Mbutton-umich/Muscle_Shirt/filterI.png

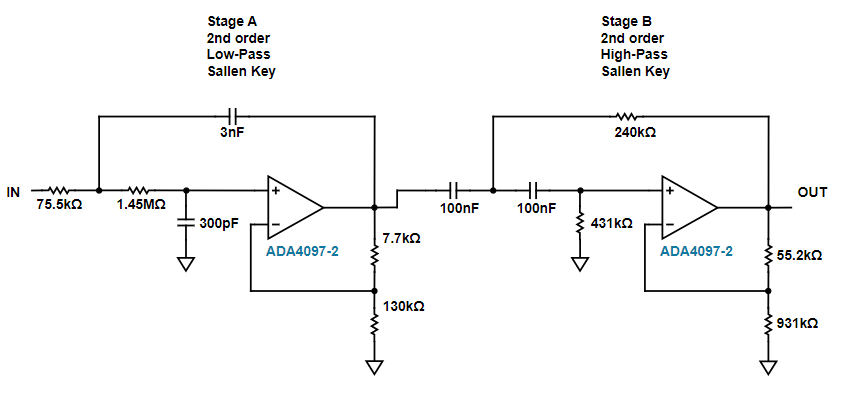
filterI.png
