Mbutton-umich/Muscle_Shirt/filterII.png

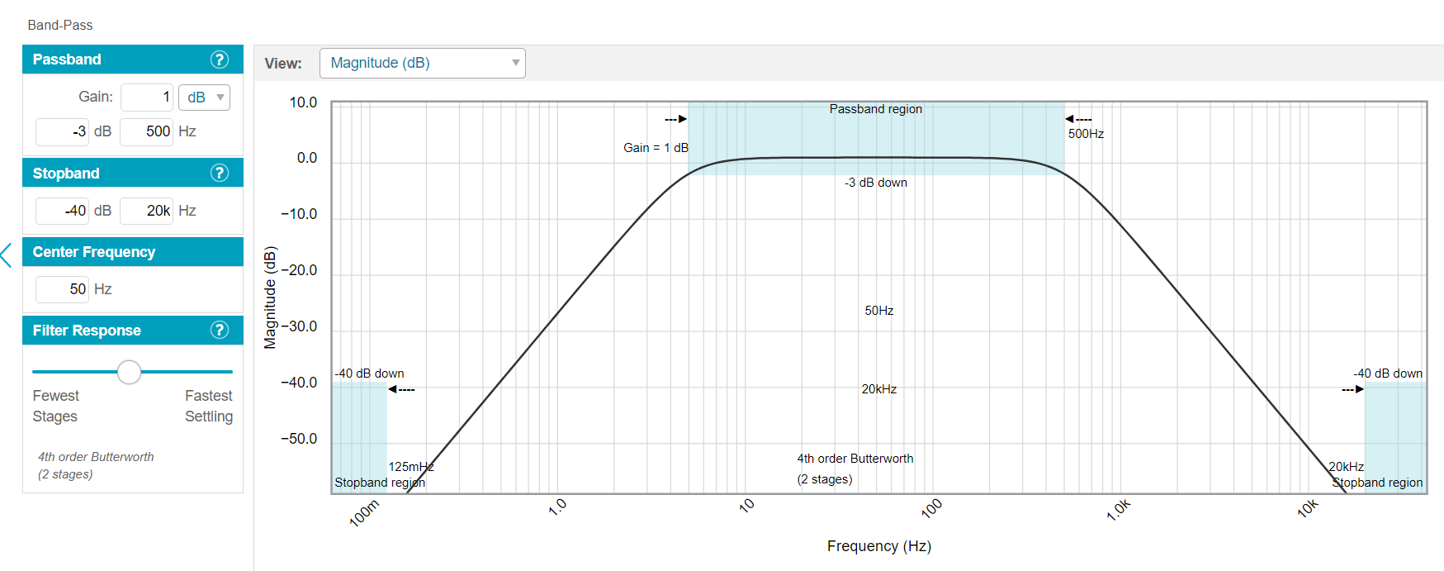
filterII.png
