Mbutton-umich/Muscle_Shirt/headers.png

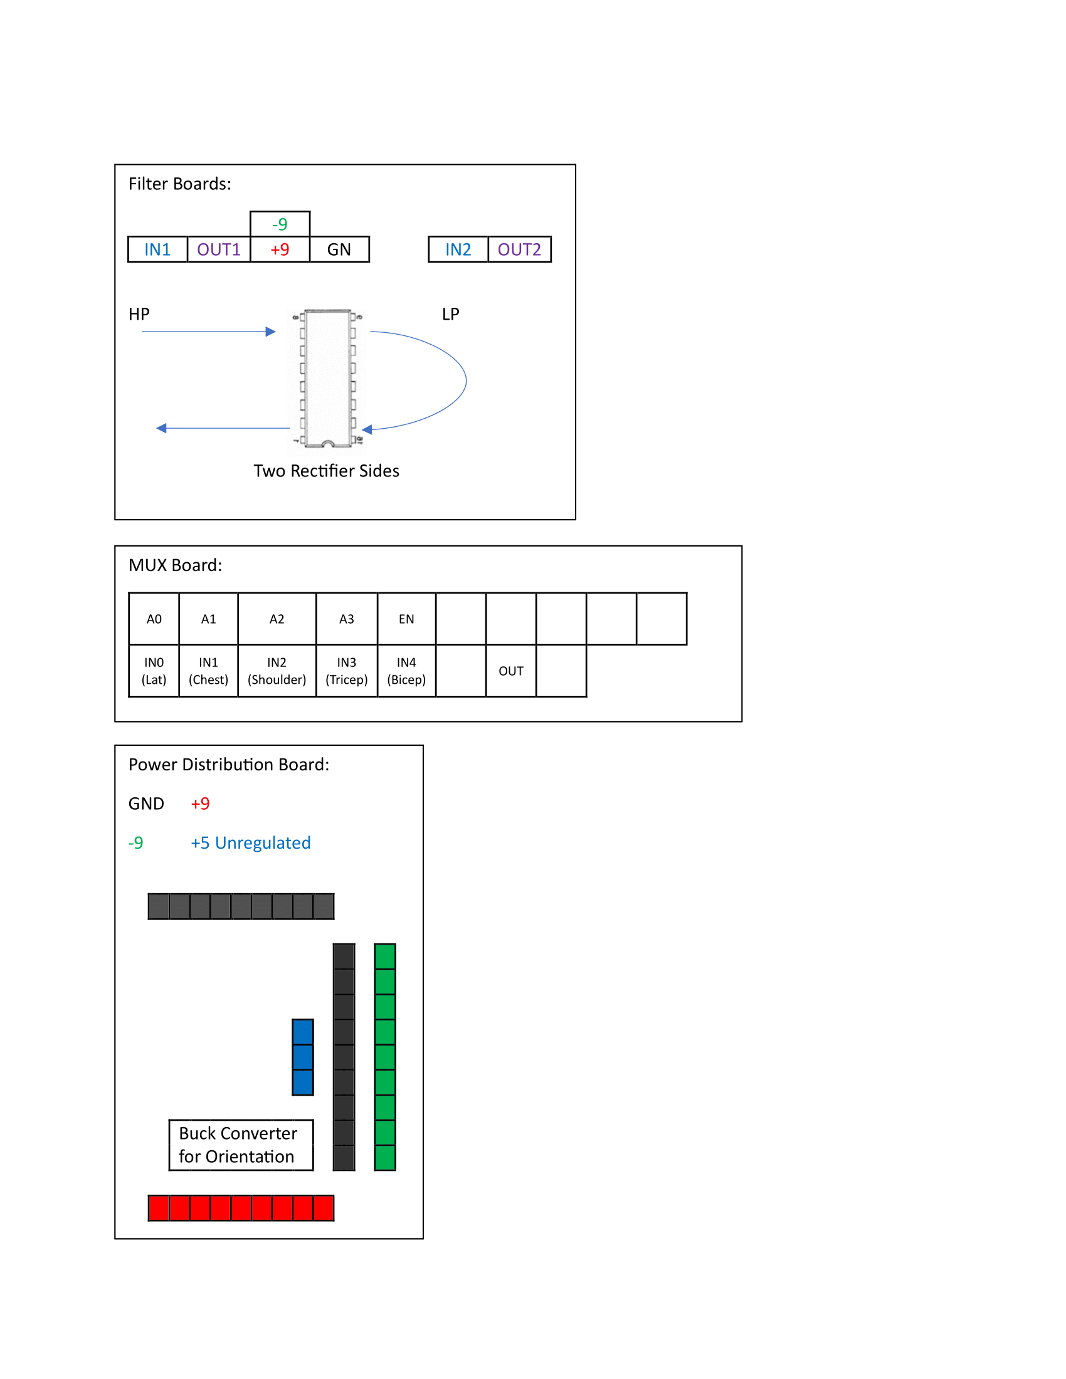
headers.png
