Mbutton-umich/Muscle_Shirt/Core/Src/main.c

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
/* Includes ------------------------------------------------------------------*/
#include "main.h"

/* USER CODE BEGIN Includes */

#include "stdio.h"				//For printf() debugging
#include "oled_screen.h"		//Obviously for the oled WE DID NOT WRITE THIS
/* USER CODE END Includes */

/* USER CODE BEGIN PTD */

//For the moving average filter
#define WINDOW_SIZE			8						//Moving average filter window size

//FOR THE ADC
#define EMG_COUNT			5						//Number of EMGs
#define STRAIN_COUNT		2						//Number of strain sensors
#define SENSOR_COUNT 		EMG_COUNT+STRAIN_COUNT 	//EMG + Strain
#define ADC_BUFFER_LENGTH	WINDOW_SIZE+3 			// 8 Window time Slots the MAX, SUM, and AVG
#define ADC_DATA_LENGTH		WINDOW_SIZE				//Width of the moving average filter that stores the data in ADC_Val
#define MAX_INDEX			WINDOW_SIZE+2			//The location the max in the tail end of the of ADC_Val
#define SUM_INDEX			WINDOW_SIZE+1			//The location the running sum in the tail end of the of ADC_Val
#define AVG_INDEX			WINDOW_SIZE				//The location the moving avg in the tail end of the of ADC_Val
#define ADC_TIMEOUT			1000 					//Millisecond timeout value for an ADC conversion

//FOR THE LEDS
#define BITS_PER			24						//3 colors of 8 bits each
#define RES_FRAME			250 					// 800kHz > T= 1.25 us, TODO: datasheet lists both  300 and also 250 us for frame reset length meaning 200 slots of PWM
#define MAX_LED 			50+10 					//(Set this to ten over because the final LED glitches for some reason)
#define BRIGHTNESS 			0.25					//Percentage of full brightness 25% gets up just to .200 A
#define BAR_SIZE 			10 						//Number of LEDs that form a bar graph at a muscle site

//FOR THE ACTIVITY LOG
#define DEPTH				32 					//Number of samples that show binary representation of activity changes
#define ACTIVITY_THRESHOLD	0.62					//Percentage of max EMG value (TODO: POWER of 2 will be faster)that is considered "Active" for the sake of recording activity
													//TODO: EXTREEMLY FINICKY: Reduced to 0.62 because a push-up is just not that hard for our purposes
/* USER CODE END PTD */

ADC_HandleTypeDef hadc1;

I2C_HandleTypeDef hi2c1;

UART_HandleTypeDef hlpuart1;

TIM_HandleTypeDef htim1;
TIM_HandleTypeDef htim2;
DMA_HandleTypeDef hdma_tim1_ch1;

/* USER CODE BEGIN PV */
//FOR THE MOVING AVERAGE FILTER
uint8_t window_timeslot = 0;									//Current position within the moving average filter
uint8_t channel = 0;											//Current EMG in terms of MUX address

//FOR THE ADC

volatile uint32_t 	ADC_Val[EMG_COUNT][ADC_BUFFER_LENGTH];		//Stores raw ADC data for every channel, the length is 8 for the moving average

//FOR THE LEDS
uint8_t bar_scalers[EMG_COUNT] = {1,1,1,1,1};					//Balances out the LED ouputs so they all look good on demo day (digital gain adjustments)
uint8_t LEDs[MAX_LED][3]; 										//LED Data that is changed reflecting true colors
uint8_t COLOR_HEATMAP[11][3]= {	{0,0,0}, 						//Heat map from green to yellow to dark red to indicate pump keep B off to reduce power
								{0, 255, 0},
								{51, 204, 0},
								{77, 178, 0},
								{102, 153, 0},
								{127,127,0},
								{153, 102, 0},
								{178, 77, 0},
								{204, 51, 0},
								{255, 0, 0},
								{255, 255, 255}}; 				//Setup as RGB
volatile uint8_t   PUMP[EMG_COUNT]; 							//Defines the current pump level 1-9, zero 0s nothing, 10 is all white
uint16_t PWM[(BITS_PER*MAX_LED)+(RES_FRAME)]; 					//PWM data that gets updated by the send function and sent via DMA there are 24 bits per individual LED plus 2 tail end bits for resetting between transmissions
volatile int DMA_Done = 0; 										//Flag to indicate a DMA transfer is ongoing

//FOR BUTTON
uint8_t clicked = 1;											//Single state keeper to prevent a second button event from firing while dealing with one

//FOR ACTIVITY MONITOR

uint8_t new_activity[EMG_COUNT]; 			//The activity fingerprint for one cycle through all the sensors, equivalently one timeslot
uint8_t activity_log[EMG_COUNT][DEPTH]; 	//Array that updates columns whenever the pattern of muscle activation changes, depth is the column count, essentially the memory for changes
uint8_t activity_index = 0;					//Location of the last updated activity column [0, DEPTH]
uint8_t push_ups = 0;						//The number of push-ups
uint32_t muscle_sums[EMG_COUNT];			//The activation counts for each muscle site
uint32_t rep_activations = 128;				//This is the number of activation peaks that translate to a single rep

//FOR FLEX SENSOR
uint16_t strain_start = 3480;
uint16_t strain_base = 3480;				//This is what the strain starts out as about 85% of the 5V max
float strain_ratio = 1;						//This minute chain in the shirt tension affects how quickly the muscles turn red by using this ratio


//For Screen
char itoa_buffer[3];
/* USER CODE END PV */

void SystemClock_Config(void);
static void MX_GPIO_Init(void);
static void MX_DMA_Init(void);
static void MX_TIM1_Init(void);
static void MX_LPUART1_UART_Init(void);
static void MX_ADC1_Init(void);
static void MX_I2C1_Init(void);
static void MX_TIM2_Init(void);
/* USER CODE BEGIN 0 */
//FOR THE ADC
//Used to read EMG data coming off the mux
void ADC_Select_EMG_MUX(void){
	ADC_ChannelConfTypeDef sConfig = {0};
	sConfig.Channel = ADC_CHANNEL_9;
	sConfig.Rank = ADC_REGULAR_RANK_1;
	sConfig.SamplingTime = ADC_SAMPLETIME_2CYCLES_5;
	sConfig.SingleDiff = ADC_SINGLE_ENDED;
	sConfig.OffsetNumber = ADC_OFFSET_NONE;
	sConfig.Offset = 0;
	if (HAL_ADC_ConfigChannel(&hadc1, &sConfig) != HAL_OK){
	  Error_Handler();
	}

}
//Adjust to another ADC channel to read strain gauges
void ADC_Select_Strain_1(void){
	ADC_ChannelConfTypeDef sConfig = {0};
	sConfig.Channel = ADC_CHANNEL_10;
	sConfig.Rank = ADC_REGULAR_RANK_1;
	sConfig.SamplingTime = ADC_SAMPLETIME_247CYCLES_5;
	if (HAL_ADC_ConfigChannel(&hadc1, &sConfig) != HAL_OK){
		Error_Handler();
	}
}

//FOR THE LEDS
//Sets a specific LED to a specific color scaled by brightness
void set_led(uint8_t LEDnum, uint8_t RGB[3]){
	//Note the ordering of the matrix is GRB, not RGB, this is deliberate for the LED strips protocol
	LEDs[LEDnum][0] = RGB[1]*BRIGHTNESS;
	LEDs[LEDnum][1] = RGB[0]*BRIGHTNESS;
	LEDs[LEDnum][2] = RGB[2]*BRIGHTNESS;
}
//Input some level from the ADC and then you get a resulting led bar graph
void set_bar_level(uint8_t channel, float level) {
	//First scale down the raw ADC EMG value to be Some number capped at 10
	//TODO: Initialize all the ADC_Val[channel][MAX_INDEX] values to 1 will prevent a divide by 0 crash, for now I just add a one but initialization will avoid stupid addition EVERY TIME
	uint16_t scaled = ((level*bar_scalers[channel])/(((ADC_Val[channel][MAX_INDEX]))))*10;

	for(int i = BAR_SIZE*channel; i < BAR_SIZE*(channel+1); ++i){
		if((i%10) < (10-scaled)) {
			set_led(i, COLOR_HEATMAP[0]);
		}else {
			set_led(i, COLOR_HEATMAP[PUMP[channel]]);
		}
	}
}

//Sends an update to DMA PWM matrix controlling LEDs
void send_DMA(void){
	uint32_t buffer_index=0;
	uint32_t GRB;
	//Loop though every LED and Update the values per bit so PWM gets set to corrrdct value
	for (int i= 0; i<MAX_LED; i++) {
		GRB = ((LEDs[i][0]<<16) | (LEDs[i][1]<<8) | (LEDs[i][2]));
		for (int i=23; i>=0; --i){
			//Recall 80M Hz clock / 100 period counter = 800k Hz desired data rate
			if (GRB&(1<<i)){
				PWM[buffer_index++] = 70;  // 7/10 of 100 TODO: These were set off of 70 and 30 to reduce flickering
			} else {
				PWM[buffer_index++] = 30;  // 3/10  of 100
			}
		}
	}
	//There is some reset time required between sends supposed to be  either 250 us or 300 datasheet is unclear
	//Also seems to work without any...
	for (int i=0; i<250; i++) {
		PWM[buffer_index++] = 0;
	}
	//Start DMA and wait till its done setting flags accordingly
	HAL_TIM_PWM_Start_DMA(&htim1, TIM_CHANNEL_1, (uint32_t *)PWM, buffer_index);
	while (!DMA_Done){};
	DMA_Done = 0;
}
//Callback to make sure DMA transfers do not step on each other sending LED data pulses
void HAL_TIM_PWM_PulseFinishedCallback(TIM_HandleTypeDef *htim){
	HAL_TIM_PWM_Stop_DMA(&htim1, TIM_CHANNEL_1);
	DMA_Done=1;

}

//Updates the EMG value for a given channel and given timeslot
void update_EMG_value(uint32_t channel, uint32_t window_timeslot){
	//Spin up the ADC channel for the EMGs
	ADC_Select_EMG_MUX();
	HAL_ADC_Start(&hadc1);
	HAL_ADC_PollForConversion(&hadc1, (uint32_t)ADC_TIMEOUT);
	//Save the old value in this timeslot
	uint32_t prior = ADC_Val[channel][window_timeslot];
	//Replace the old value with the new
	ADC_Val[channel][window_timeslot] = HAL_ADC_GetValue(&hadc1);
	//Stop the ADC
	HAL_ADC_Stop(&hadc1);
	//Recompute the running sum adding the new and subtracting the leaving old value as it passes out of the window
	ADC_Val[channel][SUM_INDEX]  = ADC_Val[channel][SUM_INDEX]  + ADC_Val[channel][window_timeslot] - prior;
	//Recompute the average from the updated sum
	ADC_Val[channel][AVG_INDEX] = ADC_Val[channel][SUM_INDEX]  /ADC_DATA_LENGTH;
	if(ADC_Val[channel][MAX_INDEX]  < ADC_Val[channel][window_timeslot]){
		ADC_Val[channel][MAX_INDEX]  = ADC_Val[channel][window_timeslot];
	}
	//Compare whatever value we just recorded to some percentage of the max. If we are over that threshold mark a 1 in the activity vector

	new_activity[channel] = (ADC_Val[channel][window_timeslot] > (ACTIVITY_THRESHOLD*ADC_Val[channel][MAX_INDEX]));
}

//Print the output of the moving average filter to console, easy to see via Arduino serial plotter
void DEBUG_print_EMG(uint8_t channel){
	//Debug print to output only
	printf("\n%u", ADC_Val[channel][AVG_INDEX] );
}

void update_strain(){
	ADC_Select_Strain_1();
	HAL_ADC_Start(&hadc1);
	HAL_ADC_PollForConversion(&hadc1, (uint32_t)ADC_TIMEOUT);
	uint16_t strain_new = HAL_ADC_GetValue(&hadc1);
	printf("\n%u", strain_new);
	HAL_ADC_Stop(&hadc1);
	if(strain_new > strain_base){
		strain_base = strain_new;
	}

}


//Neatly prints the activity matrix for debugging via Arduino serial output
void DEBUG_print_AM(void){
	//Debug print to output only
	printf("\n");
	for(uint8_t i =0; i<EMG_COUNT; ++i){
		printf("%u\t", activity_log[i][activity_index]);
	}
}

/*After cycling through all the sensors we will have some binary vector showing what muscles were on during a timeslot
 * this vector named: "new_activity" is then compared against the most recent entry in the
 */

void set_pump(float burn, uint8_t channel){
	float reps = (burn+1)/(rep_activations*strain_ratio);
	PUMP[channel] = (uint8_t)(reps) + 1;
	if(PUMP[channel] >9){
		PUMP[channel] = 9;
	}
	switch (channel) {
		case 0:
			itoa(PUMP[channel], itoa_buffer,10);
			oled_writeLat(itoa_buffer);
			break;
		case 1:
			itoa(PUMP[channel], itoa_buffer,10);
			oled_writeChest(itoa_buffer);
			break;
		case 2:
			//Shoulder doesnt fit alledgely
			break;
		case 3:
			itoa(PUMP[channel], itoa_buffer,10);
			oled_writeTricep(itoa_buffer);
			break;
		case 4:
			itoa(PUMP[channel], itoa_buffer,10);
			oled_writeBicep(itoa_buffer);
			break;
	}
}
void update_activity(void){
	//Cycle through every member of the array
	uint8_t different = 0;
	uint8_t inactive = 0;
	for(uint8_t i = 0; i<EMG_COUNT; ++i){
		//If the activity in the new column is different from the latest entry then add it
		inactive += new_activity[i];
		if(new_activity[i] != activity_log[i][activity_index]){
			//set the flag
			different = 1;
			//Break out of the loop for even a single difference, break early for optimal speed
			break;
		}
	}
	if(different) {
		//Write to some slot on the log by incrementing with wraparound
		activity_index = (activity_index+1)%DEPTH;
		//Copy this changed column into the log
		uint32_t total_pump = 0;
		for(uint8_t j = 0; j < EMG_COUNT; ++j){
			total_pump += PUMP[j];
			activity_log[j][activity_index] = new_activity[j];
			muscle_sums[j]+= new_activity[j];
		}
		itoa((total_pump/EMG_COUNT), itoa_buffer,10);
		oled_writePumpLevel(itoa_buffer);
		//DEBUG_print_AM();
		//printf("\n%u", muscle_sums[4]);

	}
	//If no muscle is currently active
	if(!inactive){
		//Determine the strain stuff
		update_strain();
		//Ratio represents how much the shirt is stretched, tighter shirt means pump is higher, go red easier
		strain_ratio = (float)(strain_base) / (float)(strain_start);
	}
	//If we made it to the end of the log, count the number of pushups so far
	if(activity_index == DEPTH){
		activity_index =0;
		for(uint8_t k = 1; k < DEPTH; ++k){
			//If chest and tri both activate then both go low
			if(activity_log[1][k-1] && activity_log[3][k-1] && !(activity_log[1][k]) && !(activity_log[3][k])){
				++push_ups;
				//Don't want to reuse the data from the top half so increment k another time
				++k;
				itoa(push_ups, itoa_buffer,10);
				oled_writePushUp(itoa_buffer);
			}
		}
	}

}




//SHIT FOR THE MUX
//Changes the mux to some other channel to read a different EMG site
void rotate_channel(uint8_t channel) {
	//TODO: Just do a lookup table for all the 8 or so sensor value and avoid the bit shifting and anding for speed
	((channel & 0b1) == 0b1)		?	HAL_GPIO_WritePin(GPIOB, GPIO_PIN_7, GPIO_PIN_SET): HAL_GPIO_WritePin(GPIOB, GPIO_PIN_7, GPIO_PIN_RESET);
	(((channel>>1) & 0b1) == 0b1)	? 	HAL_GPIO_WritePin(GPIOA, GPIO_PIN_6, GPIO_PIN_SET): HAL_GPIO_WritePin(GPIOA, GPIO_PIN_6, GPIO_PIN_RESET);
	(((channel>>2) & 0b1) == 0b1)	? 	HAL_GPIO_WritePin(GPIOB, GPIO_PIN_5, GPIO_PIN_SET): HAL_GPIO_WritePin(GPIOB, GPIO_PIN_5, GPIO_PIN_RESET);
}

void restart(void){
	strain_start = 3480;
	strain_base = 3480;
	strain_ratio = 1;
	for(unsigned int i = 0; i < EMG_COUNT; ++i){
		muscle_sums[i]=0;
		PUMP[i]=1;
		for(unsigned int j = 0; j < WINDOW_SIZE+2; ++j){
			ADC_Val[i][j] = 0;
		}
	}
}

void init_maxes(void){
	for(unsigned int i = 0 ; i < EMG_COUNT; ++i){
		//Maxes avoid divide by zero error
		ADC_Val[i][MAX_INDEX] = 4096;
		//Pump must start at 1 because 0 is off
		PUMP[i] = 1;
	}
}

//ISR fires when button is pressed and starts a timer that counts up to 50 ms for debouncing TODO: Crucial that both the button interrupts have lower (meaning higher) priorty compared to the DMA
//The DMA cannot be blocked mid stream or gets caught in a deadlock
void HAL_GPIO_EXTI_Callback(uint16_t GPIO_Pin){
	if((GPIO_Pin == GPIO_PIN_12) && (clicked > 0)){
		HAL_TIM_Base_Start_IT(&htim2);
		clicked = 0;
		DMA_Done = 1;
	}
}

//Timer for de-bouncing the restart button
void HAL_TIM_PeriodElapsedCallback(TIM_HandleTypeDef *htim){
  if(HAL_GPIO_ReadPin(GPIOA, GPIO_PIN_12) == GPIO_PIN_RESET){
	  //Send all white
	  restart();
	  for(unsigned int i = 0; i < 4; ++i) {
		  if(i%2 == 0) {
			  for(unsigned int j = 0; j < MAX_LED; ++j){
				  set_led(j, COLOR_HEATMAP[10]);
			  }
		  } else {
			  for(unsigned int k = 0; k < MAX_LED; ++k){
				  set_led(k, COLOR_HEATMAP[0]);
			  }
		  }
		  send_DMA();
		  HAL_Delay(250);
	  }
  }
  DMA_Done = 1;
  clicked = 1;
  HAL_TIM_Base_Stop_IT(&htim2);
}

/* USER CODE END 0 */

/**
  * @brief  The application entry point.
  * @retval int
  */
int main(void)
{
  /* MCU Configuration--------------------------------------------------------*/

  /* Reset of all peripherals, Initializes the Flash interface and the Systick. */
  HAL_Init();

  /* USER CODE BEGIN Init */
  // OLED test


  /* USER CODE END Init */

  /* Configure the system clock */
  SystemClock_Config();

  /* Initialize all configured peripherals */
  MX_GPIO_Init();
  MX_DMA_Init();
  MX_TIM1_Init();
  MX_LPUART1_UART_Init();
  MX_ADC1_Init();
  MX_I2C1_Init();
  MX_TIM2_Init();
  /* USER CODE BEGIN 2 */

  //Set the EN to on for the MUX
  HAL_GPIO_WritePin(GPIOB, GPIO_PIN_0, GPIO_PIN_SET);
  oled_init();
  init_maxes();
  window_timeslot = 0;

  /* USER CODE END 2 */

  /* Infinite loop */
  /* USER CODE BEGIN WHILE */
  while (1)
  {
    /* USER CODE END WHILE */

    /* USER CODE BEGIN 3 */
	  for(unsigned int i =  0; i < 5 ; ++i) {
		  rotate_channel(i);
		  update_EMG_value(i, window_timeslot);
		  set_bar_level(i, ADC_Val[i][AVG_INDEX]);
	  }
	  update_activity();
	  //DEBUG_print_EMG(0);

	  window_timeslot = (window_timeslot + 1) % WINDOW_SIZE;
	  if(window_timeslot == 0){
		  send_DMA();
	  }

  }
  /* USER CODE END 3 */
}

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
/* USER CODE BEGIN 4 */
#ifdef __GNUC__
#define PUTCHAR_PROTOTYPE int __io_putchar(int ch)
#else
  #define PUTCHAR_PROTOTYPE int fputc(int ch, FILE *f)
#endif /* __GNUC__ */
PUTCHAR_PROTOTYPE
{
  HAL_UART_Transmit(&hlpuart1, (uint8_t *)&ch, 1, 0xFFFF);
  return ch;
}

/* USER CODE END 4 */
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
