Mbutton-umich/Muscle_Shirt/FINAL.ioc

Mcu.UserName=STM32L432KCUx
PA0.GPIO_Label=MCO [High speed clock in]
PA0.Signal=RCC_CK_IN
PA10.GPIO_Label=Screen_SDA{D0)(I2C1_SDA)
PA10.Signal=I2C1_SDA
PA12.GPIO_Label=Button{D2}(GPIO_EXTI12)
PA12.Signal=GPXTI12
PA2.Signal=LPUART1_TX
PA3.Signal=LPUART1_RX
PA4.GPIO_Label=EMG_ADC_IN{A3}(ADC1_IN9)
PA4.Signal=ADCx_IN9
PA5.GPIO_Label=Strain_ADC_IN{A4}(ADC1_IN10)
PA5.Signal=ADCx_IN10
PA6.GPIO_Label=MUX_A1{A5}(GPIO_Output)
PA6.Signal=GPIO_Output
PA8.GPIO_Label=LED_PWM{D9}(TIM1_CH1)
PA8.Signal=S_TIM1_CH1
PA9.GPIO_Label=Screen_SCL{D1}(I2C1_SCL)
PA9.Signal=I2C1_SCL
PB0.GPIO_Label=MUX_EN{D3}(GPIO_Output)
PB0.Signal=GPIO_Output
PB1.GPIO_Label=ADC_IN{D6}(ADC1_IN16)
PB1.Signal=ADCx_IN16
PB5.GPIO_Label=MUX_A2{D11}(GPIO_Output)
PB5.Signal=GPIO_Output
PB7.GPIO_Label=MUX_A0{D4}(GPIO_Output)
PB7.Signal=GPIO_Output
