Mbutton-umich/Muscle_Shirt/Core/Inc/main.h

#define MCO_Pin GPIO_PIN_0
#define MCO_GPIO_Port GPIOA
#define EMG_ADC_IN_A3__Pin GPIO_PIN_4
#define EMG_ADC_IN_A3__GPIO_Port GPIOA
#define Strain_ADC_IN_A4__Pin GPIO_PIN_5
#define Strain_ADC_IN_A4__GPIO_Port GPIOA
#define MUX_A1_A5__Pin GPIO_PIN_6
#define MUX_A1_A5__GPIO_Port GPIOA
#define MUX_EN_D3__Pin GPIO_PIN_0
#define MUX_EN_D3__GPIO_Port GPIOB
#define ADC_IN_D6__Pin GPIO_PIN_1
#define ADC_IN_D6__GPIO_Port GPIOB
#define LED_PWM_D9__Pin GPIO_PIN_8
#define LED_PWM_D9__GPIO_Port GPIOA
#define Screen_SCL_D1__Pin GPIO_PIN_9
#define Screen_SCL_D1__GPIO_Port GPIOA
#define Screen_SDA_D0__Pin GPIO_PIN_10
#define Screen_SDA_D0__GPIO_Port GPIOA
#define Button_D2__Pin GPIO_PIN_12
#define Button_D2__GPIO_Port GPIOA
#define Button_D2__EXTI_IRQn EXTI15_10_IRQn
#define SWDIO_Pin GPIO_PIN_13
#define SWDIO_GPIO_Port GPIOA
#define SWCLK_Pin GPIO_PIN_14
#define SWCLK_GPIO_Port GPIOA
#define VCP_RX_Pin GPIO_PIN_15
#define VCP_RX_GPIO_Port GPIOA
#define LD3_Pin GPIO_PIN_3
#define LD3_GPIO_Port GPIOB
#define MUX_A2_D11__Pin GPIO_PIN_5
#define MUX_A2_D11__GPIO_Port GPIOB
#define MUX_A0_D4__Pin GPIO_PIN_7
#define MUX_A0_D4__GPIO_Port GPIOB
