Mbutton-umich/Muscle_Shirt/(commit log)

2023-04-24 Final Submission II
    Drivers Uplaod Final Submission
2023-04-24 Filter Specs
    Filter Specs
2023-04-25 Updated to include header pin diagram info
2023-04-25 Buck note
